AlexSchmitz222/DCC-Decoder/README.md

# DCC-Decoder
DIY DCC Decoder with 16 Outputs for Use with MARDEC or ARSIGDEC Software by ArCoMoRa (https://www.arcomora.com/)

License Model: CC BY-NC-ND (https://creativecommons.org/licenses/by-nc-nd/4.0/legalcode / https://creativecommons.org/licenses/by-nc-nd/4.0/)
