AlexSchmitz222/DCC-Decoder/Teileliste.xlsx

THT
Value | Package | Parts | Description | Händler | Bestellnr. | Einzelpreis | Anmerkungen | Menge 16 | Gesamt 16 | Menge 12 | Gesamt 12 | Menge 6 | Gesamt 6
ATMEGA328P-PU | DIP794W46P254L2967H457Q28B | U1 | ATMega 328P-PU | Reichelt | ARD ATMEGA 328 | 5.15 |  | 1 | 5.15 | 1 | 5.15 | 1 | 5.15
R-78B5.0-2.0 | CONV_v | PS1, PS2, PS3, PS4 | DC/DC Wandler 5V, 2A | Mouser | 946-MEZD71202A-G | 4.54 | //ALT.: R-78B5.0-2.0 | 4 | 18.16 | 3 | 13.62 | 2 | 9.08
MCP2221 | DIL14 | IC1 | USB/UART Bridge | Mouser | 579-MCP2221A-I/P | 2.56 |  | 1 | 2.56 | 1 | 2.56 | 1 | 2.56
Platine |  |  | Platine | JLCPCB |  | 2.38 |  | 1 | 2.38 | 1 | 2.38 | 1 | 2.38
BS250 | SOT54E | Q3, Q5, Q7, Q9, Q11, Q13, Q15, Q17, Q19, Q21, Q23, Q25, Q27, Q29, Q31, Q33 | P-Channel MOSFET | Mouser | 522-BS250P | 0.746 | Ab 10 Stk: 0,746, sonst 0,831 | 16 | 11.94 | 12 | 8.96 | 6 | 4.48
6N137 | DIL08 | OK1 | Optokoppler | Mouser | 859-6N137 | 0.71 |  | 1 | 0.71 | 1 | 0.71 | 1 | 0.71
16Mhz | HC49U-V | Q1 | Quarz | Conrad | 155145 - 62 | 0.64 |  | 1 | 0.64 | 1 | 0.64 | 1 | 0.64
 | MKDSN1,5/3-5,08 | X1, X2, X3, X4, X5, X6, X7, X8, X9, X10, X11, X12, X13, X14, X15, X16 | Schraubterminal, 3polig | Conrad | 732208 - 62 | 0.6 | RM 5,08mm | 16 | 9.6 | 12 | 7.2 | 6 | 3.6
10-24V | MKDSN1,5/2-5,08 | POWER_IN, DCC_IN | Schraubterminal, 2polig | Conrad | 732195 - 62 | 0.49 | RM 5,08mm | 2 | 0.98 | 2 | 0.98 | 2 | 0.98
1N5817-B | DO41-7.6 | D19 | Schottky Diode | Mouser | 511-1N5817 | 0.36 |  | 1 | 0.36 | 1 | 0.36 | 1 | 0.36
FP: B3F-10XX | B3F-10XX | S1 | Taster | Mouser | 653-B3F-1000 | 0.27 | B3F-1000 | 1 | 0.27 | 1 | 0.27 | 1 | 0.27
 | 2X05 | PRG_HEADER | Pin Header 2x05 | Conrad | 734200 - 62 | 0.23 |  | 1 | 0.23 | 1 | 0.23 | 1 | 0.23
1N5400 | DO201-15 | D1, D2, D3, D4, D6, D7, D8, D9, D10, D11, D12, D13, D14, D15, D16, D17 | Diode | Conrad | 1581847 - 62 | 0.18 |  | 16 | 2.88 | 12 | 2.16 | 8 | 1.44
470uF | E5-10,5 | C16, C17, C18, C19, C20, C21, C22, C23 | Elektrolytkondensator | Conrad | 442625 - 62 | 0.18 | >24V | 8 | 1.44 | 6 | 1.08 | 4 | 0.72
BS170 | SOT54E | Q2, Q4, Q6, Q8, Q10, Q12, Q14, Q16, Q18, Q20, Q22, Q24, Q26, Q28, Q30, Q32 | N-Channel MOSFET | Conrad | 158950 - 62 | 0.18 |  | 16 | 2.88 | 12 | 2.16 | 6 | 1.08
GELB | LED3MM | LED22 | LED | Conrad | 1577458 - 62 | 0.17 |  | 1 | 0.17 | 1 | 0.17 | 1 | 0.17
1uF | C050-025X075 | C1, C2, C4, C5, C6, C7, C8, C9 | Keramikkondensator | Conrad | 1578741 - 62 | 0.16 | >24V | 8 | 1.28 | 48 | 7.68 | 4 | 0.64
100nF | C050-025X075 | C3, C10, C11, C13, C24 | Keramikkondensator | Conrad | 458211 - 62 | 0.14 |  | 5 | 0.7 | 5 | 0.7 | 5 | 0.7
GRÜN | LED3MM | LED21 | LED | Conrad | 1577309 - 62 | 0.14 |  | 1 | 0.14 | 1 | 0.14 | 1 | 0.14
330nF | C025-030X050 | C12 | Keramikkondensator | Conrad | 1578719 - 62 | 0.13 |  | 1 | 0.13 | 1 | 0.13 | 1 | 0.13
ROT | LED3MM | LED1, LED2, LED3, LED4, LED5, LED6, LED7, LED8, LED9, LED10, LED11, LED12, LED13, LED14, LED15, LED16, LED17, LED18, LED19, LED20 | LED | Conrad | 1577379 - 62 | 0.13 |  | 20 | 2.6 | 15 | 1.95 | 8 | 1.04
22pF | C025-030X050 | C14, C15 | Keramikkondensator | Conrad | 1589504 - 62 | 0.07 |  | 2 | 0.14 | 2 | 0.14 | 2 | 0.14
220Ohm | 0207/7 | R4, R21, R22, R40, R41, R42 | Widerstand, bedrahtet | Conrad | 1557508 - 62 | 0.07 |  | 6 | 0.42 | 5 | 0.35 | 4 | 0.28
1.5k | 0207/7 | R3, R5, R6, R9, R12, R15, R18, R23, R26, R29, R32, R35, R38, R48, R51, R54, R57 | Widerstand, bedrahtet | Conrad | 1585441 - 62 | 0.07 |  | 17 | 1.19 | 13 | 0.91 | 7 | 0.49
10k | 0207/7 | R1, R2, R7, R8, R10, R11, R13, R14, R16, R17, R19, R20, R24, R25, R27, R28, R30, R31, R33, R34, R36, R37, R39, R43, R44, R45, R46, R47, R49, R50, R52, R53, R55, R56, R58, R59 | Widerstand, bedrahtet | Conrad | 1584127 - 62 | 0.07 |  | 36 | 2.52 | 28 | 1.96 | 16 | 1.12
3.3k | 0207/7 | 3,3K, 3,3K1, 3,3K2, 3,3K3, 3,3K4, 3,3K5, 3,3K6, 3,3K7, 3,3K8, 3,3K9, 3,3K10, 3,3K11, 3,3K12, 3,3K13, 3,3K14, 3,3K15 | Widerstand, bedrahtet | Conrad | 1585445 - 62 | 0.07 |  | 16 | 1.12 | 12 | 0.84 | 6 | 0.42
1N4148 | DO35-7 | D5 | Diode | Conrad | 564851 - 62 | 0.05 |  | 1 | 0.05 | 1 | 0.05 | 1 | 0.05
 | 1X03 | JP1, JP2, JP3, JP4, JP5, JP6, JP7, JP8, JP9, JP10, JP11, JP12, JP13, JP14, JP15, JP16, JP17, JP18, JP19, JP20, JP21, JP22, JP23, JP24, JP25, JP26, JP27, JP28, JP29, JP30, JP31, JP32 | Pin Header 1x03 | Conrad | 1560729 - 62 | 0.05 |  | 32 | 1.6 | 24 | 1.2 | 12 | 0.6
MICRO-USB | MICRO-USB | U$1 | Micro USB B connector |  |  |  |  | 1 | 0 | 1 | 0 | 1 | 0
 |  |  |  |  |  |  |  | Gesamt | 72.24 | € | 64.68 | € | 39.6 | €
SMD
Value | Package | Parts | Description | Händler | Bestellnr. | Einzelpreis | Anmerkungen | Menge 16 | Gesamt 16 | Menge 12 | Gesamt 12 | Menge 6 | Gesamt 6
ATMEGA328P-PU | DIP794W46P254L2967H457Q28B | U1 | ATMega 328P-PU | Reichelt | ARD ATMEGA 328 | 5.15 | //THT | 1 | 5.15 | 1 | 5.15 | 1 | 5.15
R-78B5.0-2.0 | CONV_v | PS1, PS2, PS3, PS4 | DC/DC Wandler 5V, 2A | Mouser | 946-MEZD71202A-G | 4.54 | //ALT.: R-78B5.0-2.0 //Netzteil -> THT | 4 | 18.16 | 3 | 13.62 | 2 | 9.08
MCP2221 | DIL14 | IC1 | USB/UART Bridge | Mouser | 579-MCP2221A-I/P | 2.56 | //THT | 1 | 2.56 | 1 | 2.56 | 1 | 2.56
Platine |  |  | Platine | JLCPCB |  | 2.38 |  | 1 | 2.38 | 1 | 2.38 | 1 | 2.38
6N137 | DIL08 | OK1 | Optokoppler | LCSC | C142297 (https://lcsc.com/product-detail/Optocouplers-Logic-Output_Everlight-Elec-6N137_C142297.html) | 0.3415 | //THT | 1 | 0.35 | 1 | 0.35 | 1 | 0.35
 | MKDSN1,5/3-5,08 | X1, X2, X3, X4, X5, X6, X7, X8, X9, X10, X11, X12, X13, X14, X15, X16 | Schraubterminal, 3polig | LCSC | C387825 (https://lcsc.com/product-detail/Screw-terminal_JILN-JL500-50803G01_C387825.html) | 0.258 | RM 5,08mm | 16 | 4.13 | 12 | 3.1 | 6 | 1.55
1N5400 | DO201-15 | D1, D2, D3, D4, D6, D7, D8, D9, D10, D11, D12, D13, D14, D15, D16, D17 | Diode | Conrad | 1581847 - 62 | 0.18 | //Netzteil -> THT | 16 | 2.88 | 12 | 2.16 | 8 | 1.44
470uF | E5-10,5 | C16, C17, C18, C19, C20, C21, C22, C23 | Elektrolytkondensator | Conrad | 442625 - 62 | 0.18 | >24V //Netzteil -> THT | 8 | 1.44 | 6 | 1.08 | 4 | 0.72
1uF | C050-025X075 | C1, C2, C4, C5, C6, C7, C8, C9 | Keramikkondensator | Conrad | 1578741 - 62 | 0.16 | >24V //Netzteil -> THT | 8 | 1.28 | 0 | 0 | 4 | 0.64
FP: B3F-10XX | B3F-10XX | S1 | Taster | LCSC | C93157 (https://lcsc.com/product-detail/Tactile-Switches_Omron-Electronics-B3F-1000_C93157.html) | 0.1433 | B3F-1000 | 1 | 0.15 | 1 | 0.15 | 1 | 0.15
 | 2X05 | PRG_HEADER | Pin Header 2x05 | LCSC | C2894966 (https://lcsc.com/product-detail/Pin-Headers_HCTL-PZ254-2-05-Z-8-5_C2894966.html) | 0.1226 |  | 1 | 0.13 | 1 | 0.13 | 1 | 0.13
BS250 | SOT54E | Q3, Q5, Q7, Q9, Q11, Q13, Q15, Q17, Q19, Q21, Q23, Q25, Q27, Q29, Q31, Q33 | P-Channel MOSFET | LCSC | C558099 (https://lcsc.com/product-detail/MOSFETs_VBsemi-Elec-BS250FTA_C558099.html) | 0.0857 |  | 16 | 1.38 | 12 | 1.03 | 6 | 0.52
16Mhz | HC49U-V | Q1 | Quarz | LCSC | C16212 (https://lcsc.com/product-detail/Crystals_Yangxing-Tech-X49SD16MSD2SC_C16212.html) | 0.0786 |  | 1 | 0.08 | 1 | 0.08 | 1 | 0.08
10-24V | MKDSN1,5/2-5,08 | POWER_IN, DCC_IN | Schraubterminal, 2polig | LCSC | C709041 (https://lcsc.com/product-detail/Screw-terminal_JILN-JL500-50802G01_C709041.html) | 0.0733 | RM 5,08mm | 2 | 0.15 | 2 | 0.15 | 2 | 0.15
BS170 | SOT54E | Q2, Q4, Q6, Q8, Q10, Q12, Q14, Q16, Q18, Q20, Q22, Q24, Q26, Q28, Q30, Q32 | N-Channel MOSFET | LCSC | C558098 (https://lcsc.com/product-detail/MOSFETs_VBsemi-Elec-BS170FTA_C558098.html) | 0.0575 |  | 16 | 0.92 | 12 | 0.69 | 6 | 0.35
MICRO-USB | MICRO-USB | U$1 | Micro USB B connector | LCSC | C404969 (https://lcsc.com/product-detail/span-style-background-color-ff0-USB-span-Connectors_SHOU-HAN-MicroXNJ_C404969.html) | 0.0515 |  | 1 | 0.06 | 1 | 0.06 | 1 | 0.06
1N5817-B | DO41-7.6 | D19 | Schottky Diode | LCSC | C2828419 (https://lcsc.com/product-detail/Schottky-Barrier-Diodes-SBD_CBI-1N5817W-SJ_C2828419.html) | 0.0345 |  | 1 | 0.04 | 1 | 0.04 | 1 | 0.04
10k | 0207/7 | R1, R2, R7, R8, R10, R11, R13, R14, R16, R17, R19, R20, R24, R25, R27, R28, R30, R31, R33, R34, R36, R37, R39, R43, R44, R45, R46, R47, R49, R50, R52, R53, R55, R56, R58, R59 | Widerstand, bedrahtet | LCSC | C17414 (https://lcsc.com/product-detail/Chip-Resistor-Surface-Mount_UNI-ROYAL-Uniroyal-Elec-0805W8F1002T5E_C17414.html) | 0.026 |  | 36 | 0.94 | 28 | 0.73 | 16 | 0.42
1.5k | 0207/7 | R3, R5, R6, R9, R12, R15, R18, R23, R26, R29, R32, R35, R38, R48, R51, R54, R57 | Widerstand, bedrahtet | LCSC | C4310 (https://lcsc.com/product-detail/Chip-Resistor-Surface-Mount_UNI-ROYAL-Uniroyal-Elec-0805W8F1501T5E_C4310.html) | 0.026 |  | 17 | 0.45 | 13 | 0.34 | 7 | 0.19
220Ohm | 0207/7 | R4, R21, R22, R40, R41, R42 | Widerstand, bedrahtet | LCSC | C17557 (https://lcsc.com/product-detail/Chip-Resistor-Surface-Mount_UNI-ROYAL-Uniroyal-Elec-0805W8F2200T5E_C17557.html) | 0.026 |  | 6 | 0.16 | 5 | 0.13 | 4 | 0.11
3.3k | 0207/7 | 3,3K, 3,3K1, 3,3K2, 3,3K3, 3,3K4, 3,3K5, 3,3K6, 3,3K7, 3,3K8, 3,3K9, 3,3K10, 3,3K11, 3,3K12, 3,3K13, 3,3K14, 3,3K15 | Widerstand, bedrahtet | LCSC | C26020 (https://lcsc.com/product-detail/Chip-Resistor-Surface-Mount_UNI-ROYAL-Uniroyal-Elec-0805W8J0332T5E_C26020.html) | 0.022 |  | 16 | 0.36 | 12 | 0.27 | 6 | 0.14
GELB | LED3MM | LED22 | LED | LCSC | C84262 (https://lcsc.com/product-detail/Light-Emitting-Diodes-span-style-background-color-ff0-LED-span_Foshan-NationStar-Optoelectronics-NCD0805O1_C84262.html) | 0.0216 |  | 1 | 0.03 | 1 | 0.03 | 1 | 0.03
 | 1X03 | JP1, JP2, JP3, JP4, JP5, JP6, JP7, JP8, JP9, JP10, JP11, JP12, JP13, JP14, JP15, JP16, JP17, JP18, JP19, JP20, JP21, JP22, JP23, JP24, JP25, JP26, JP27, JP28, JP29, JP30, JP31, JP32 | Pin Header 1x03 | LCSC | C49257 (https://lcsc.com/product-detail/Pin-Headers_BOOMELE-Boom-Precision-Elec-C49257_C49257.html) | 0.019 |  | 32 | 0.61 | 24 | 0.46 | 12 | 0.23
ROT | LED3MM | LED1, LED2, LED3, LED4, LED5, LED6, LED7, LED8, LED9, LED10, LED11, LED12, LED13, LED14, LED15, LED16, LED17, LED18, LED19, LED20 | LED | LCSC | C84256 (https://lcsc.com/product-detail/Light-Emitting-Diodes-span-style-background-color-ff0-LED-span_Foshan-NationStar-Optoelectronics-NCD0805R1_C84256.html) | 0.0144 |  | 20 | 0.29 | 15 | 0.22 | 8 | 0.12
ORANGE | LED3MM | LED21 | LED | LCSC | C84256 (https://lcsc.com/product-detail/Light-Emitting-Diodes-span-style-background-color-ff0-LED-span_Foshan-NationStar-Optoelectronics-NCD0805R1_C84256.html) | 0.0144 |  | 1 | 0.02 | 1 | 0.02 | 1 | 0.02
22pF | C025-030X050 | C14, C15 | Keramikkondensator | LCSC | C1804 (https://lcsc.com/product-detail/Multilayer-Ceramic-Capacitors-MLCC-SMD-SMT_Samsung-Electro-Mechanics-CL21C220JBANNNC_C1804.html) | 0.013 |  | 2 | 0.03 | 2 | 0.03 | 2 | 0.03
330nF | C025-030X050 | C12 | Keramikkondensator | LCSC | C73142 (https://lcsc.com/product-detail/Multilayer-Ceramic-Capacitors-MLCC-SMD-SMT_Samsung-Electro-Mechanics-CL21B334KBFNNNE_C73142.html) | 0.0123 |  | 1 | 0.02 | 1 | 0.02 | 1 | 0.02
1N4148 | DO35-7 | D5 | Diode | LCSC | C917030 (https://lcsc.com/product-detail/Switching-Diode_JSMSEMI-1N4148W_C917030.html) | 0.0111 |  | 1 | 0.02 | 1 | 0.02 | 1 | 0.02
100nF | C050-025X075 | C3, C10, C11, C13, C24 | Keramikkondensator | LCSC | C1711 (https://lcsc.com/product-detail/Multilayer-Ceramic-Capacitors-MLCC-SMD-SMT_Samsung-Electro-Mechanics-CL21B104KBCNNNC_C1711.html) | 0.0058 |  | 5 | 0.03 | 5 | 0.03 | 5 | 0.03
 |  |  |  |  |  |  |  | Gesamt | 44.2 | € | 35.03 | € | 26.71 | €
