AlexSchmitz222/DCC-Decoder/SMD Components/Schaltplan V1.0.brd

## EAGLE design SMD Components/Schaltplan V1.0.brd (2022-02-05)

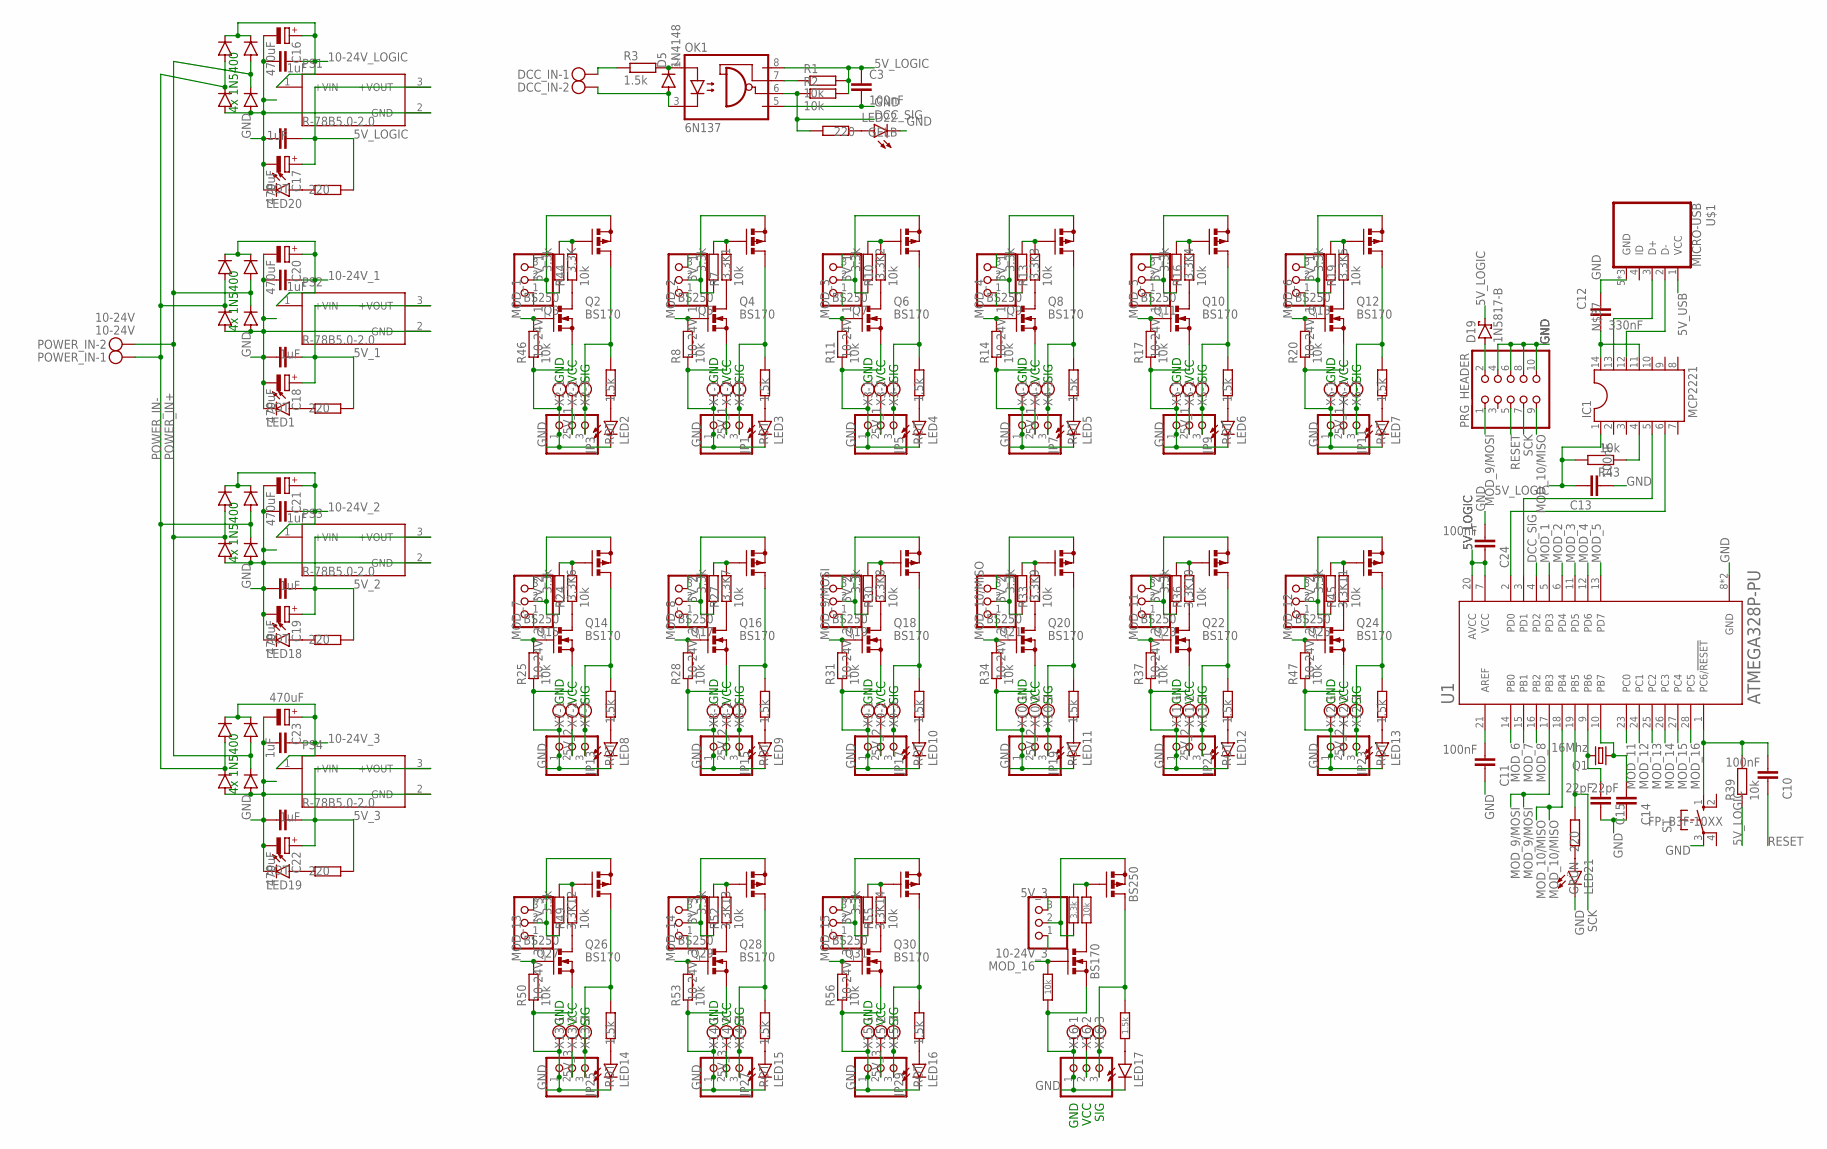
[picture p1: schematic Schaltplan V1.0.sch]

Parts:
3,3K, 3,3K1, 3,3K2, 3,3K3, 3,3K4, 3,3K5, 3,3K6, 3,3K7, 3,3K8, 3,3K9, 3,3K10, 3,3K11, 3,3K12, 3,3K13, 3,3K14, 3,3K15: 3.3k; 0207/7
C1, C2, C4, C5, C6, C7, C8, C9: 1uF; C050-025X075
C3, C10, C11, C13, C24: 100nF; C025-025X050
C12: 330nF; C025-025X050
C14, C15: 22pF; C025-030X050
C16, C17, C18, C19, C20, C21, C22, C23: 470uF; E5-10,5
D1, D2, D3, D4, D6, D7, D8, D9, D10, D11, D12, D13, D14, D15, D16, D17: 1N5400; DO201-15
D5: 1N4148; DO35-7
D19: 1N5817-B; DO41-7.6
DCC_IN: MKDSN1,5/2-5,08
IC1: MCP2221; DIL14
JP1, JP2, JP3, JP4, JP5, JP6, JP7, JP8, JP9, JP10, JP11, JP12, JP13, JP14, JP15, JP16, JP17, JP18, JP19, JP20, JP21, JP22, JP23, JP24, JP25, JP26, JP27, JP28, JP29, JP30, JP31, JP32: PINHD-1X3; 1X03
LED1, LED2, LED3, LED4, LED5, LED6, LED7, LED8, LED9, LED10, LED11, LED12, LED13, LED14, LED15, LED16, LED17, LED18, LED19, LED20: ROT; LED3MM
LED21: GRÜN; LED3MM
LED22: GELB; LED3MM
OK1: 6N137; DIL08
POWER_IN: 10-24V; MKDSN1,5/2-5,08
PRG_HEADER: PINHD-2X5; 2X05
PS1, PS2, PS3, PS4: R-78B5.0-2.0; CONV_R-78B5.0-2.0
Q1: 16Mhz; HC49U-V
Q2, Q4, Q6, Q8, Q10, Q12, Q14, Q16, Q18, Q20, Q22, Q24, Q26, Q28, Q30, Q32: BS170; SOT54E
Q3, Q5, Q7, Q9, Q11, Q13, Q15, Q17, Q19, Q21, Q23, Q25, Q27, Q29, Q31, Q33: BS250; SOT54E
R1, R2, R7, R8, R10, R11, R13, R14, R16, R17, R19, R20, R24, R25, R27, R28, R30, R31, R33, R34, R36, R37, R39, R43, R44, R45, R46, R47, R49, R50, R52, R53, R55, R56, R58, R59: 10k; 0207/7
R3, R5, R6, R9, R12, R15, R18, R23, R26, R29, R32, R35, R38, R48, R51, R54, R57: 1.5k; 0207/7
R4, R21, R22, R40, R41, R42: 220; 0207/7
S1: FP: B3F-10XX; B3F-10XX
U1: ATMEGA328P-PU; DIP794W46P254L2967H457Q28B
U$1: MICRO-USB
X1, X2, X3, X4, X5, X6, X7, X8, X9, X10, X11, X12, X13, X14, X15, X16: MKDSN1,5/3-5,08

Connections:
5V_1: C1.2, C18.+, JP1.2, JP2.3, JP3.2, JP4.3, JP5.2, JP6.3, JP7.2, JP8.3, JP9.2, JP10.3, JP11.2, JP12.3, PS2.3 (+VOUT), R4.2, X1.2, X2.2, X3.2, X4.2, X5.2, X6.2
5V_2: C4.2, C19.+, JP13.2, JP14.3, JP15.2, JP16.3, JP17.2, JP18.3, JP19.2, JP20.3, JP21.2, JP22.3, JP23.2, JP24.3, PS3.3 (+VOUT), R21.2, X7.2, X8.2, X9.2, X10.2, X11.2, X12.2
5V_3: C6.2, C22.+, JP25.2, JP26.3, JP27.2, JP28.3, JP29.2, JP30.3, JP31.2, JP32.3, PS4.3 (+VOUT), R22.2, X13.2, X14.2, X15.2, X16.2
5V_LOGIC: C3.1, C8.2, C13.1, C17.+, C24.1, D19.C, IC1.1, OK1.8 (VCC), PS1.3 (+VOUT), R1.2, R2.2, R39.1, R40.2, R43.2, U1.7 (VCC), U1.20 (AVCC)
5V_USB: U$1.1 (VCC)
10-24V_1: C2.2, C20.+, D1.C, D3.C, JP2.1, JP4.1, JP6.1, JP8.1, JP10.1, JP12.1, PS2.1 (+VIN)
10-24V_2: C5.2, C21.+, D6.C, D8.C, JP14.1, JP16.1, JP18.1, JP20.1, JP22.1, JP24.1, PS3.1 (+VIN)
10-24V_3: C7.2, C23.+, D10.C, D12.C, JP26.1, JP28.1, JP30.1, JP32.1, PS4.1 (+VIN)
10-24V_LOGIC: C9.2, C16.+, D14.C, D16.C, PS1.1 (+VIN)
AREF: C11.2, U1.21 (AREF)
DCC_SIG: OK1.6 (VO), R2.1, R42.2, U1.4 (PD2)
GND: C1.1, C2.1, C3.2, C4.1, C5.1, C6.1, C7.1, C8.1, C9.1, C11.1, C12.1, C13.2, C14.1, C15.1, C16.-, C17.-, C18.-, C19.-, C20.-, C21.-, C22.-, C23.-, C24.2, D2.A, D4.A, D7.A, D9.A, D11.A, D13.A, D15.A, D17.A, JP1.1, JP3.1, JP5.1, JP7.1, JP9.1, JP11.1, JP13.1, JP15.1, JP17.1, JP19.1, JP21.1, JP23.1, JP25.1, JP27.1, JP29.1, JP31.1, LED1.K (C), LED2.K (C), LED3.K (C), LED4.K (C), LED5.K (C), LED6.K (C), LED7.K (C), LED8.K (C), LED9.K (C), LED10.K (C), LED11.K (C), LED12.K (C), LED13.K (C), LED14.K (C), LED15.K (C), LED16.K (C), LED17.K (C), LED18.K (C), LED19.K (C), LED20.K (C), LED21.K (C), LED22.K (C), OK1.5 (GND), PRG_HEADER.4, PRG_HEADER.6, PRG_HEADER.8, PRG_HEADER.10, PS1.2 (GND), PS2.2 (GND), PS3.2 (GND), PS4.2 (GND), Q2.S, Q4.S, Q6.S, Q8.S, Q10.S, Q12.S, Q14.S, Q16.S, Q18.S, Q20.S, Q22.S, Q24.S, Q26.S, Q28.S, Q30.S, Q32.S, R8.1, R11.1, R14.1, R17.1, R20.1, R25.1, R28.1, R31.1, R34.1, R37.1, R46.1, R47.1, R50.1, R53.1, R56.1, R59.1, S1.3, U1.8 (GND), U1.22 (GND), U$1.5 (GND), U$1.GND1 (GND), U$1.GND2 (GND), X1.1, X2.1, X3.1, X4.1, X5.1, X6.1, X7.1, X8.1, X9.1, X10.1, X11.1, X12.1, X13.1, X14.1, X15.1, X16.1
MOD_1: Q2.G, R46.2, U1.5 (PD3)
MOD_2: Q4.G, R8.2, U1.6 (PD4)
MOD_3: Q6.G, R11.2, U1.11 (PD5)
MOD_4: Q8.G, R14.2, U1.12 (PD6)
MOD_5: Q10.G, R17.2, U1.13 (PD7)
MOD_6: Q12.G, R20.2, U1.14 (PB0)
MOD_7: Q14.G, R25.2, U1.15 (PB1)
MOD_8: Q16.G, R28.2, U1.16 (PB2)
MOD_9/MOSI: PRG_HEADER.1, Q18.G, R31.2, U1.17 (PB3)
MOD_10/MISO: PRG_HEADER.9, Q20.G, R34.2, U1.18 (PB4)
MOD_11: Q22.G, R37.2, U1.23 (PC0)
MOD_12: Q24.G, R47.2, U1.24 (PC1)
MOD_13: Q26.G, R50.2, U1.25 (PC2)
MOD_14: Q28.G, R53.2, U1.26 (PC3)
MOD_15: Q30.G, R56.2, U1.27 (PC4)
MOD_16: Q32.G, R59.2, U1.28 (PC5)
unnamed: DCC_IN.1, R3.1
unnamed: LED1.A, R4.1
unnamed: LED18.A, R21.1
unnamed: D5.C, OK1.2 (A), R3.2
unnamed: JP3.3, Q3.D, R5.2, X2.3
unnamed: JP1.3, Q5.D, R6.2, X1.3
unnamed: LED19.A, R22.1
unnamed: OK1.7 (VE), R1.1
unnamed: 3,3K13.1, Q29.G, R52.2
unnamed: LED20.A, R40.1
unnamed: LED3.A, R6.1
unnamed: 3,3K.2, JP4.2, Q3.S
unnamed: LED2.A, R5.1
unnamed: LED21.A, R41.1
unnamed: 3,3K12.1, Q27.G, R49.2
unnamed: Q4.D, R7.1
unnamed: LED22.A, R42.1
unnamed: 3,3K1.2, JP2.2, Q5.S
unnamed: JP5.3, Q7.D, R9.2, X3.3
unnamed: LED4.A, R9.1
unnamed: IC1.5, U1.3 (PD1)
unnamed: Q2.D, R44.1
unnamed: IC1.4, R43.1
unnamed: IC1.13, U$1.3 (D+)
unnamed: 3,3K14.1, Q31.G, R55.2
unnamed: Q6.D, R10.1
unnamed: 3,3K2.2, JP6.2, Q7.S
unnamed: JP7.3, Q9.D, R12.2, X4.3
unnamed: IC1.6, U1.2 (PD0)
unnamed: IC1.12, U$1.2 (D-)
unnamed: LED5.A, R12.1
unnamed: 3,3K15.1, Q33.G, R58.2
unnamed: Q8.D, R13.1
unnamed: C12.2, IC1.11, IC1.14
unnamed: D19.A, PRG_HEADER.2
unnamed: 3,3K3.2, JP8.2, Q9.S
unnamed: JP9.3, Q11.D, R15.2, X5.3
unnamed: LED6.A, R15.1
unnamed: Q10.D, R16.1
unnamed: 3,3K4.2, JP10.2, Q11.S
unnamed: JP11.3, Q13.D, R18.2, X6.3
unnamed: LED7.A, R18.1
unnamed: Q12.D, R19.1
unnamed: D5.A, DCC_IN.2, OK1.3 (C)
unnamed: 3,3K5.2, JP12.2, Q13.S
unnamed: JP13.3, Q15.D, R23.2, X7.3
unnamed: LED8.A, R23.1
unnamed: 3,3K5.1, Q13.G, R19.2
unnamed: Q14.D, R24.1
unnamed: 3,3K6.2, JP14.2, Q15.S
unnamed: JP15.3, Q17.D, R26.2, X8.3
unnamed: LED9.A, R26.1
unnamed: 3,3K4.1, Q11.G, R16.2
unnamed: Q16.D, R27.1
unnamed: 3,3K7.2, JP16.2, Q17.S
unnamed: JP17.3, Q19.D, R29.2, X9.3
unnamed: LED10.A, R29.1
unnamed: 3,3K3.1, Q9.G, R13.2
unnamed: Q18.D, R30.1
unnamed: 3,3K8.2, JP18.2, Q19.S
unnamed: JP19.3, Q21.D, R32.2, X10.3
unnamed: LED11.A, R32.1
unnamed: 3,3K10.1, Q23.G, R36.2
unnamed: Q20.D, R33.1
unnamed: 3,3K9.2, JP20.2, Q21.S
unnamed: JP21.3, Q23.D, R35.2, X11.3
unnamed: LED12.A, R35.1
unnamed: 3,3K2.1, Q7.G, R10.2
unnamed: Q22.D, R36.1
unnamed: 3,3K10.2, JP22.2, Q23.S
unnamed: JP23.3, Q25.D, R38.2, X12.3
unnamed: LED13.A, R38.1
unnamed: 3,3K1.1, Q5.G, R7.2
unnamed: Q24.D, R45.1
unnamed: 3,3K11.2, JP24.2, Q25.S
unnamed: JP25.3, Q27.D, R48.2, X13.3
unnamed: LED14.A, R48.1
unnamed: Q26.D, R49.1
unnamed: 3,3K12.2, JP26.2, Q27.S
unnamed: JP27.3, Q29.D, R51.2, X14.3
unnamed: LED15.A, R51.1
unnamed: Q28.D, R52.1
unnamed: 3,3K13.2, JP28.2, Q29.S
unnamed: JP29.3, Q31.D, R54.2, X15.3
unnamed: LED16.A, R54.1
unnamed: Q30.D, R55.1
unnamed: 3,3K14.2, JP30.2, Q31.S
unnamed: JP31.3, Q33.D, R57.2, X16.3
unnamed: LED17.A, R57.1
unnamed: Q32.D, R58.1
unnamed: 3,3K15.2, JP32.2, Q33.S
unnamed: 3,3K9.1, Q21.G, R33.2
unnamed: 3,3K11.1, Q25.G, R45.2
unnamed: 3,3K8.1, Q19.G, R30.2
unnamed: 3,3K7.1, Q17.G, R27.2
unnamed: 3,3K6.1, Q15.G, R24.2
unnamed: 3,3K.1, Q3.G, R44.2
POWER_IN+: D3.A, D4.C, D6.A, D7.C, D12.A, D13.C, D16.A, D17.C, POWER_IN.2
POWER_IN-: D1.A, D2.C, D8.A, D9.C, D10.A, D11.C, D14.A, D15.C, POWER_IN.1
QUARTZ_1: C15.2, Q1.2, U1.9 (PB6)
QUARTZ_2: C14.2, Q1.1, U1.10 (PB7)
RESET: C10.1, PRG_HEADER.5
RESET_MC: C10.2, R39.2, S1.1 (S), U1.1 (PC6/!RESET)
SCK: PRG_HEADER.7, R41.2, U1.19 (PB5)

Notes on the sheet:
4x 1N5400
SIG
VCC
GND

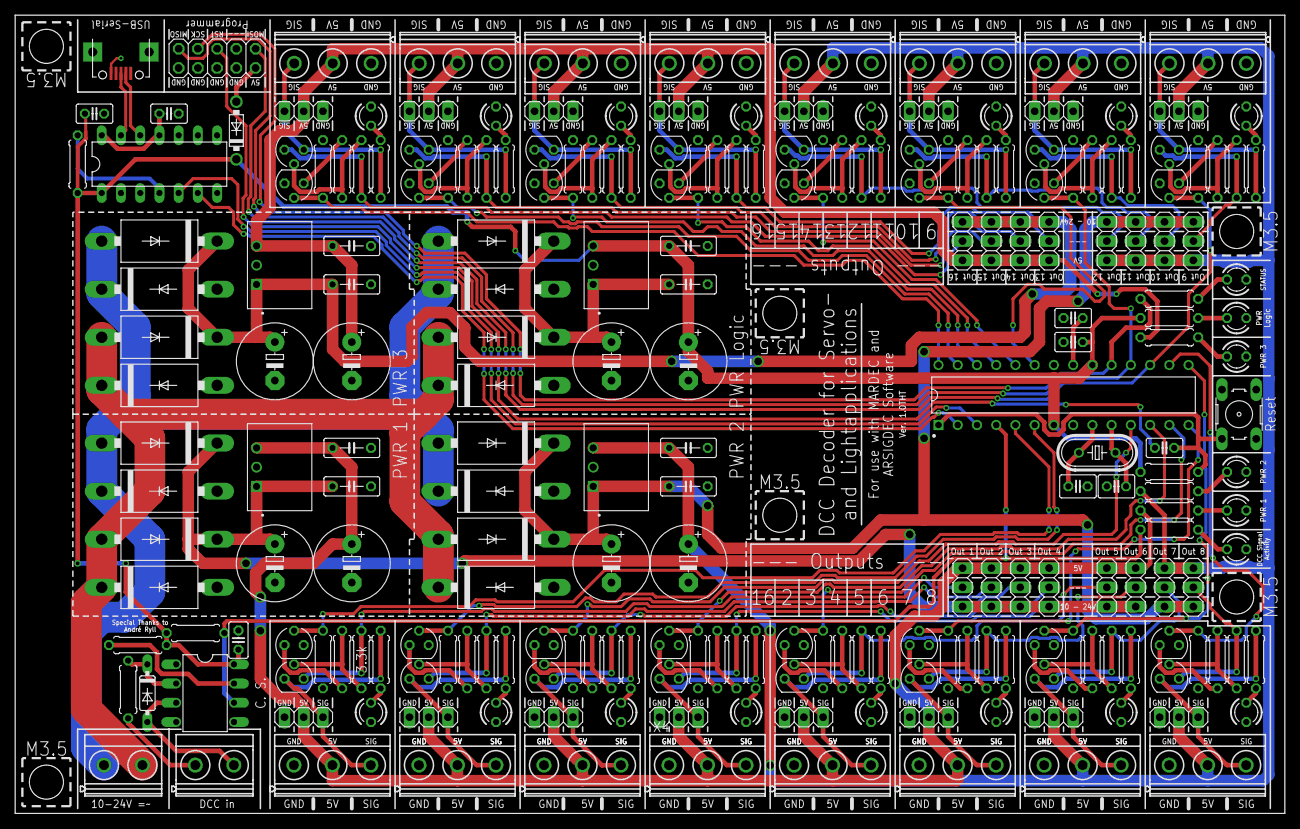
[picture p2: board Schaltplan V1.0.brd from above]

Board: 2 copper layers, 167.7 x 105.4 mm, 232 parts (0 on the bottom side), 131 nets.
