AlexSchmitz222/DCC-Decoder/(commit log)

2022-02-04 Initial Push of Schematic and Layout (only THT Components)
    [Schaltplan V1.0.brd, Schaltplan V1.0.sch]
2022-02-05 added SMD Variant
    [Schaltplan V1.0.brd, Schaltplan V1.0.sch, Teileliste.xlsx]
2022-02-06 added SMD Parts
    [Teileliste.xlsx]
2022-02-06 fixed Parts List
    [Teileliste.xlsx]
2022-02-06 Update Schaltplan V1.0.brd
    [Schaltplan V1.0.brd]
